dsb92/pokaljagten/README.txt

I dette projekt har vi haft til opgave at programmere og lave ekstra hardware til en bil. 
Vi har været 8 mand fra AU Ingeniørhøjskolen om projekt.  
Vi har haft omkring et helt semester til at få kendskab og skabe erfaringer nok, fra 5 forskellige fag og til slut at ende ud med at samle det hele i dette projekt, med hjælp fra en vejleder. 
Vi har kæmpet hård.  
I projektet her kommer vi ind på bla. programmet motor styring ved hjælp af timer og PWM signal, programmering af lyd som er forskellige lyde fra Mario. 
Vi kommer også ind på programmering af lys, både for- og baglys, og nogle lys effekter, plus refleks detektorer, med tilhørende Hardware. 
Det hele skal så ende ud i at vores færdige projekt skal ud og dyste i den store pokaljagt.

Hvad jeg har arbejdet med: Lyddriver, C kode til at afspille Super Mario lyd i forskellige scenarier fra bilen.
