dsb92/pokaljagten/Implementering/Software/Main_2/Main/Main2.c

/*
 * Main2.c
 *
 * Created: 15-01-2013 13:03:26
 *  Author: David
 */ 

//*********HEADER-FILER*********
#include <avr/io.h>
#include "Lyddriver.h"
#include "Lys_functions.h"
#include "Motor klasse.h"
#include "uart.h"
#include "switch.h"
#include <avr/interrupt.h>
#include <util/delay.h>
#include <stdlib.h>
#define F_CPU 3686400UL
#define XTAL 3686400
//******************************


//********PROTOTYPER************
void initTimer0( void );
void initTimer1( void );
void initTimer2( void );
void ReflectionCount( void );
//******************************


//*****GLOBALE VARIABLER********
int antalRefleksbrik = 0;
//******************************


int main(void)
{
	/*
	initSwitchPort();
	
	if( switchStatus() & 0b00100000 )
	{
		*/
		initTimer0();		// Timer0 - Lys/Lyd
		initTimer1();		// Timer1 - Lyd(OCR1A) og Delays
		initTimer2();		// Timer2 - Motorstyring
		initBackLEDPort();	
		initFrontLEDPort();
	
		/*
		InitUART( 9800, 8);
		DDRA |= 0b00010000;
	
		PORTA |= 0b00010000; //sætter PA4 høj for at tælleren kan køre
	
		while( 'S' != ReadChar() )
		{
		
			if( 'R' == ReadChar() )
			{
				PORTA &= ~( 1 << 4 );	// sætter PA4 lav og dermed trigger reset på tæller = tælleren resat
				_delay_ms( 500 );		// delay sikre at det lave signal registreres af tællerkredsløbet
				PORTA |= 0b00010000;	//sætter PA4 høj for at tælleren kan køre igen
			}
		}
		*/
		sei();
		_delay_us(5000000);
		allLightsOn();	// Tænd alle lys
	
		while(1)
		{
			
			do 
			{
				ReflectionCount();
				DriveForward1();
				brakeLightOff();
			
				if( antalRefleksbrik == 4 )	// Brems ved bakken.
				{
					Brake();
					brakeLightOn();
				}
			
				if( antalRefleksbrik == 6 )	// Bremse og bak.
				{
					//Brake();
					brakeLightOn();
					Reverse();
				}
				
				if( antalRefleksbrik > 10) // 9
				{
					DriveForward2(); 
				}
			
				if( antalRefleksbrik == 9 )	// Når den holder ved refleksbrik nr 5.
				{
					Brake();
					_delay_us(5000000);
				}
			} while ( antalRefleksbrik >=0 && antalRefleksbrik <=12 );
		
			if( antalRefleksbrik > 12 )
			{
				Brake();
				brakeLightNormal();
				StopLevelComplete();
			}
		
		}
	
	return 0;
}

//******TIMERS********
void initTimer0( void )
{
	// Timer0: PWM Mode, Clock = 3,6864 MHz/1024 = 3600 Hz
	// => Overflow frekvens = 3600 Hz / 8 = 450 Hz
	// Prescaler 1
	TCCR0 = 0b01100001;
	//Timer0 ikke-fast PWM mode, compare match set when up counting
}


void initTimer1( void )
{
	// CTC mode (mode 4), OC1A:"Normal port operation"
	TCCR1A = 0b00000000;
	// Prescaler = 1 (timer 1 clock = 3,6864 MHz)
	TCCR1B = 0b00001001;
	// Ben OC1A (= PORTD bit 5) sættes til udgang
	
	DDRD |= 0b00110000;
}

void initTimer2( void )
{
	// PWM Phase correct.
	// Set OC2 on compare match when up-counting. Clear OC2 downcounting.
	// Prescaling 256.
	TCCR2 = 0b01110100;
}
//**********************


void ReflectionCount( void )
{
	DDRC = 0xFF;	// Fri udgang
	PORTC = 0xFF;
	
	DDRA &= 0b11110011;	// PA2 og PA3 sættes til indgang
	
	while( PINA & 0b00000100 || PINA & 0b00001000 )
	{
		DetekCoin();
		//Tæl antal én op
		antalRefleksbrik++;
		_delay_us(2000000);
	}
}

/*
void T1Delay( void )
{
	// Benfrekvens 100 Hz ?
	OCR1B = 18432;	// Delay på 0,005*100 = 0,5 sekunder, hvis overflowfrekvensen er 100 - laves i en while-løkke.
	
	TIMSK |= 0b00001000;	// Enabler interrupt
	// ( TIMSK = 0b00101000; hvis TICIE1 enabled? )
}



//******TIMER1-COMPAREB INTERRUPT******
ISR( TIMER1_COMPB_vect )	// Compare-interrupt for PD4.
{
	
	counter++;
	
}
//************************************
*/
