dsb92/pokaljagten/Implementering/Software/Main/Main/Lys_functions.h

/*
 * Lys_functions.h
 *
 * Created: 06/12/2012 13:40:34
 *  Author: RaZak
 */ 
void initFrontLEDPort( );
void initBackLEDPort( );
void allLightsOn( );
void allLightsOff( );
void brakeLightOn( );
void brakeLightOff( );
